rcshadman/OnSpeed-Gen2/Software/OnSpeedESP32S3/hardware/hardware.html

# OnSpeed on the ESP32-S3: hardware build

Board diagram, wiring schematic, pin map and parts list for replacing the Teensy 3.6 in an OnSpeed Gen2 box. Prices checked 2026-10-25, in USD.

Complete new box

$0

Every part bought new

Upgrading a Gen2 box

$0

Reusing sensors, IMU, enclosure, fittings, display

Pressure sensors

$0

Half the new-box cost; already in a Gen2 box

GPIO used

23 of 33

Plus USB for the console. No strapping or PSRAM pins

## Board diagram

The DevKitC-1 sits on a protoboard inside the existing Gen2 enclosure. Every connection to the aircraft is wired; there is no Wi-Fi in flight. Each colour is one kind of signal.

PowerI²C AnalogAudio (I²S) SerialCAN SD cardNumbers on the wires are ESP32-S3 GPIOs

## Wiring schematic

The four circuits that matter most for noise and reliability, drawn to the values in the parts list. Everything else is a direct wire from a module pin to the GPIO in the pin map.

## Connector pinout

The Gen2 DB-15 and harness are kept as they are, so an existing aircraft needs no rewiring. Pins come from the Gen2 Eagle netlist. MakerPlane CAN gets its own DB-9 because the DB-15 has no free pins.

DB-15 pin | Signal | To ESP32-S3 | Notes
1 | +12–14 V in | power chain → 5V | Through the 0.5 A PTC (Gen2 F1)
2 | EFIS RX (RS-232) | MAX3232 R1 → GPIO 15 | For example a Garmin G5 or Dynon serial out
3 | Panel switch | GPIO 5 | Data mark. Held at power-up, it enters ground maintenance mode
4 | GPS / VN-300 RX | MAX3232 R2 → GPIO 16
5 | AOA LED | GPIO 6 | 150R in series
6, 8 | Audio left / right | PCM5102A via the pad | Gen2 coupling caps C7 / C6. The PCM5102A output is already ground-centred
7 | Flap position | GPIO 1 | Divider + 100 nF
9 | Display TX | GPIO 10 | To the M5Stack, 3.3 V TTL
10 | Volume | GPIO 2 | Divider + 100 nF
11 | 3.3 V out | 3V3 via MF-R010 | Sensor/boom supply, Gen2 F2
12 | EFIS TX (RS-232) | GPIO 11 → MAX3232 T1
13 | Boom TTL RX | GPIO 7 | 3.3 V logic only; check each aircraft before connecting
14 | Ground | GND | Power return
15 | Audio ground | DAC AGND | Ground at the audio panel only
DB-9 (MakerPlane): pin 2 CAN-L, pin 7 CAN-H, pin 3 CAN GND, pin 1 +12–30 V (not used, box is powered from the DB-15), pin 5 power GND, pin 8 shield

## Pin map

GPIO | Signal | Peripheral | Why this pin

Left alone on purpose: 0, 3, 45, 46 (boot strapping), 35–37 (octal PSRAM), 19/20 (USB console), 43/44 (USB-UART bridge and ROM boot log), 38/48 (on-board LED). GPIO 11–20 are on ADC2, which Wi-Fi shares, so they carry only digital signals. The product PCB should use a WROOM-1-N8, never a "V" module.

## Flap sensor

All three options use the same input (DB-15 pin 7). The firmware learns each detent in a ground calibration, switches stage with hysteresis and a 0.2 s debounce, and holds the last good stage if the sensor fails open or short.

Option | How it works | Fit | Approx. cost
Linear Hall sensor (recommended for new installs) | A magnet on the flap torque tube, a Honeywell SS49E-type sensor on the structure. No contact, nothing to wear out. | Any stage count. Needs a small bracket. | $3–5
Position potentiometer (Ray Allen POS-12 or similar) | Many aircraft already have one for a flap indicator. Its wiper goes to pin 7. | Reuse what is installed. | already fitted
Detent switches + resistor ladder | One microswitch per detent, each switching in a different resistor, so one wire carries the stage. | Cheapest, but switches can bounce or corrode. | $5–10

## Parts list

Complete new box Upgrade a Gen2 box

Part | What it does | Qty | Unit | Total | Buy
Total

Prices are from the vendors' pages or findchips on 2026-10-25; small passives are approximate. Not included: the aircraft wiring and flap sensor, the optional ADS1115 ($14.95, only if the ESP32-S3 ADC proves too noisy) and, later, a custom PCB (about $5–30 for five boards plus a $4–5 WROOM-1 module).

## Noise and reliability

Each item below is a problem found in the datasheets, Espressif's docs or issue trackers, and what the build or firmware does about it.

Risk | Real numbers | What is done about it
Pressure sensor noise | MS4525DO: 1.05 Pa per count, about 1.5 counts RMS. One P45 count is 0.085° of AOA at 50 kt. | Median-of-15 then average-of-10 filter, as Gen2. Unit tests: steady AOA error 0.038°.
Bad or stale sensor reads | Status bits 10 = stale, 11 = fault. Gen2 ignored them. | Stale and faulty samples rejected. 25 bad reads in a row mutes the tones instead of giving a wrong tone; it recovers on its own.
I²C hang | ESP-IDF issue 12929: the bus can lock with a stuck device. | 2 ms timeouts and a bus reset after 10 failures. External 4.7k pull-ups (the internal 45k is too weak).
I²C speed | Gen2 ran at 3 MHz; the S3 tops out at 400 kHz. A 4-byte read takes 117.5 µs. | All reads for one 20 ms cycle take under 1 ms of bus time.
ADC noise | About 3 LSB RMS, 6 with Wi-Fi on, spikes near 30 LSB. Reference varies 1.0–1.2 V by chip. | ADC1 only, curve-fitted calibration, 32-sample average, 100 nF at the pin. Flap detents sit hundreds of counts apart.
Audio clock | The PCM5102A PLL cannot lock to 22.05 kHz. | I²S at 44.1 kHz.
Audio level | DAC 2.1 Vrms full scale; audio panel music inputs want under 0.2 Vrms at full volume. | −12 dB pad plus a firmware cap. Set it on the ground with the audio panel.
Pops at power-up | XSMT ramp 104 samples; the PLL needs 16 LRCK periods. | XSMT held low by a pull-down until I²S is clocking zeros.
Power transients | Bus can drop below 7 V when cranking; hot-plug spikes can pass 50 V. | D36V28F5 runs from 5.3 V, TVS + PTC, 47 µF bulk, brownout detector on.
Wi-Fi | Raises ADC noise and costs CPU. | Off in flight. Only on in ground maintenance mode (panel button held at power-up) or over USB.
Ground loops | Gen2 shares power and audio ground on the board. | Audio ground only at the audio panel; shielded twisted pair.
CPU headroom | CoreMark: S3 1329.92, Teensy 3.6 440.72. | About 3× the Teensy, with the second core free for the AHRS or display.

## Bench tests before flight

These can only be checked on real hardware. None of them should be skipped.

- Measure flap ADC noise in mV at each detent, with and without Wi-Fi. If detents are not cleanly separated, fit the ADS1115.
- Check the audio level and listen for hum on the actual audio panel, engine running.
- Power-cycle and crank the engine with the box on: no reset, no pop.
- Measure the boom and display logic levels on each aircraft before connecting (3.3 V only).
- Pull a sensor connector in flight-like conditions on the bench and confirm the tones mute and come back.
- Redo the AOA calibration flight: the 5 V-calibrated MS4525DO parts run at 3.3 V, as in Gen2. New builds can buy the 3.3 V version (DS3).
- Ask the FlyOnSpeed team (team@flyonspeed.org) about their ESP32 V4B board before laying out a PCB.
