rcshadman/OnSpeed-Gen2/Hardware/OnSpeedS3/fab/onspeed_bom_jlc.csv

Comment | Designator | Footprint | LCSC Part # | MPN | Qty
22uF 100V | C1 | CP_Elec_8x10 | C116424 | CS2A220M-CRF10 | 1
100nF | C2,C5 | C_0805_2012Metric | C28233 |  | 2
2.2uF | C3,C4 | C_1210_3225Metric | C86054 |  | 2
2.2nF | C6,C8,C47,C48 | C_0603_1608Metric | C1604 |  | 4
220pF | C7 | C_0805_2012Metric | C1805 |  | 1
22uF | C9,C10,C15,C20 | C_0805_2012Metric | C45783 |  | 4
100nF | C11,C12,C16,C18,C21,C22,C25,C26,C28,C29,C30,C31,C32,C33,C34,C36,C37,C40,C42,C43,C45,C49,C50,C51,C52,C53,C55,C57,C59 | C_0603_1608Metric | C14663 |  | 29
4.7uF | C13,C56 | C_0805_2012Metric | C1779 |  | 2
10uF | C14,C17,C19,C27,C41,C44,C46,C58 | C_0805_2012Metric | C15850 |  | 8
1uF | C23,C35 | C_0603_1608Metric | C15849 |  | 2
10nF | C24 | C_0603_1608Metric | C57112 |  | 1
2.2uF | C38,C39 | C_0603_1608Metric | C23630 |  | 2
4.7nF | C54 | C_0603_1608Metric | C53987 |  | 1
SS210 | D1 | D_SMA | C14996 | SS210 | 1
SMBJ58A | D2 | D_SMB | C10226 | SMBJ58A | 1
SS14 | D3,D19 | D_SMA | C2480 | SS14 | 2
Green | D4 | LED_0603_1608Metric | C72043 | 19-217/GHC-YR1S2/3T | 1
Blue | D5 | LED_0603_1608Metric | C72041 | 19-217/BHC-ZL1M2RY/3T | 1
15V bidir ESD | D6,D7,D8,D10,D11,D12,D13,D14 | D_SOD-323 | C2985482 | PESD15VL1BA | 8
24V bidir ESD | D9 | D_SOD-323 | C314263 | PESD24VL1BA | 1
BAT54S | D15,D16,D17,D18 | SOT-23 | C19726 | BAT54SLT1G | 4
PESD2CAN | D20 | SOT-23 | C2687131 | PESD2CAN | 1
0.75A 60V PTC | F1 | Fuse_2920_7451Metric | C210842 | MF-SM075/60-2 | 1
0.1A 15V PTC | F2 | Fuse_0603_1608Metric | C883088 | BSMD0603-010-15V | 1
220R@100MHz 2A | FB1 | L_0805_2012Metric | C85840 | BLM21PG221SN1D | 1
600R@100MHz 1.3A | FB2,FB3,FB4 | L_0603_1608Metric | C85833 | BLM18KG601SN1D | 3
USB-C 16P | J1 | USB_C_Receptacle_HRO_TYPE-C-31-M-12 | C165948 | TYPE-C-31-M-12 | 1
DA-15 female | J2 | DSUB-15_Female_Horizontal_P2.77x2.84mm_EdgePinOffset9.40mm_Holes33.32mm | C77835 | DS1037-15FNAKT74-0CC | 1
JST-GH 4P | J3 | JST_GH_SM04B-GHS-TB_1x04-1MP_P1.25mm_Horizontal | C189895 | SM04B-GHS-TB(LF)(SN) | 1
DE-9 male | J4 | DSUB-9_Male_Horizontal_P2.77x2.84mm_EdgePinOffset9.40mm_Holes24.99mm | C75750 | DS1037-09MNAKT74-0CC | 1
microSD push-pull | J5 | microSD_HC_Molex_104031-0811 | C585350 | 104031-0811 | 1
33uH 1.8A shielded | L1 | L_Changjiang_FNR6045S | C168083 | FNR6045S330MT | 1
330k | R1 | R_0603_1608Metric | C23137 |  | 1
100k | R2,R4,R6,R9 | R_0603_1608Metric | C25803 |  | 4
31.6k | R3,R5 | R_0603_1608Metric | C25967 |  | 2
150k | R7 | R_0603_1608Metric | C22807 |  | 1
8.2k | R8 | R_0603_1608Metric | C25981 |  | 1
5.1k | R10,R11 | R_0603_1608Metric | C23186 |  | 2
470 | R12,R15,R38,R40,R42,R44 | R_0603_1608Metric | C23179 |  | 6
10k | R13,R14,R37,R50,R52,R53,R54,R55,R56,R57 | R_0603_1608Metric | C25804 |  | 10
1k | R16,R25 | R_0603_1608Metric | C21190 |  | 2
20k | R17 | R_0603_1608Metric | C4184 |  | 1
150 | R18,R24 | R_0603_1608Metric | C22808 |  | 2
22k | R19,R21,R22 | R_0603_1608Metric | C31850 |  | 3
5.6k | R20,R23 | R_0603_1608Metric | C23189 |  | 2
0 | R26 | R_0603_1608Metric | C21189 |  | 1
200k | R27,R32 | R_0603_1608Metric | C25811 |  | 2
4.7k | R28,R29,R30,R31,R33,R34,R35,R36 | R_0603_1608Metric | C23162 |  | 8
560 | R39,R43 | R_0603_1608Metric | C23204 |  | 2
100 | R41,R45 | R_0603_1608Metric | C22775 |  | 2
120 | R46,R47,R48,R49 | R_0603_1608Metric | C22787 |  | 4
33 | R51 | R_0603_1608Metric | C23140 |  | 1
Tactile 4.2x3.2mm | SW1,SW2 | SW_SPST_PTS810 | C221895 | PTS810SJG250SMTRLFS | 2
LM5164DDAR | U1 | SOIC-8-1EP_3.9x4.9mm_P1.27mm_EP2.95x4.9mm_Mask2.71x3.4mm_ThermalVias | C477928 | LM5164DDAR | 1
USBLC6-2SC6 | U2 | SOT-23-6 | C7519 | USBLC6-2SC6 | 1
LDL1117S33R | U3 | SOT-223-3_TabPin2 | C435835 | LDL1117S33R | 1
ESP32-S3-WROOM-1-N8 | U4 | ESP32-S3-WROOM-1_BodyCourtyard | C2913198 | ESP32-S3-WROOM-1-N8 | 1
MS4525DO-DS5AI001DP | U5,U6 | MS4525DO_DIP8_500mil |  | MS4525DO-DS5AI001DP | 2
SSCSRNN1.6BA7A3 | U7 | Honeywell_SSC_SIP4_RN |  | SSCSRNN1.6BA7A3 | 1
PCA9306DCUR | U8,U9 | VSSOP-8_2.3x2mm_P0.5mm | C33196 | PCA9306DCUR | 2
ISM330DHCX | U10 | LGA-14_3x2.5mm_P0.5mm_LayoutBorder3x4y | C2655101 | ISM330DHCXTR | 1
PCM5102APWR | U11 | TSSOP-20_4.4x6.5mm_P0.65mm | C107671 | PCM5102APWR | 1
SP3232EEN-L/TR | U12 | SOIC-16_3.9x9.9mm_P1.27mm | C9378 | SP3232EEN-L/TR | 1
TJA1051T/3/1J | U13 | SOIC-8_3.9x4.9mm_P1.27mm | C38695 | TJA1051T/3/1J | 1
