rcshadman/OnSpeed-Gen2/Hardware/OnSpeedS3/enclosure/onspeed_enclosure_lid.stl

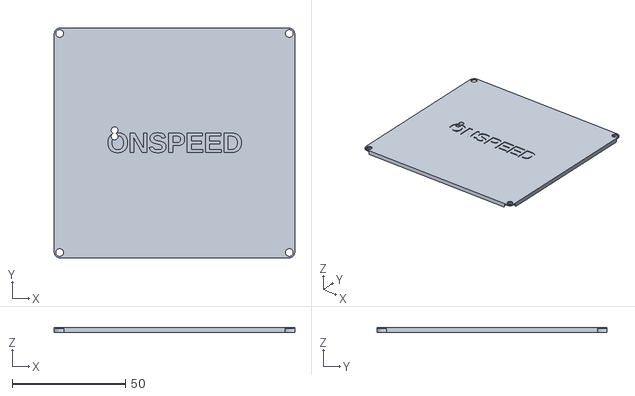
[picture p1: CAD file, 2026-10-25]
Hardware/OnSpeedS3/enclosure/onspeed_enclosure_lid.stl
106.2 x 101.5 x 2.40
