rcshadman/OnSpeed-Gen2/Hardware/OnSpeedS3/fab/onspeed_board.step

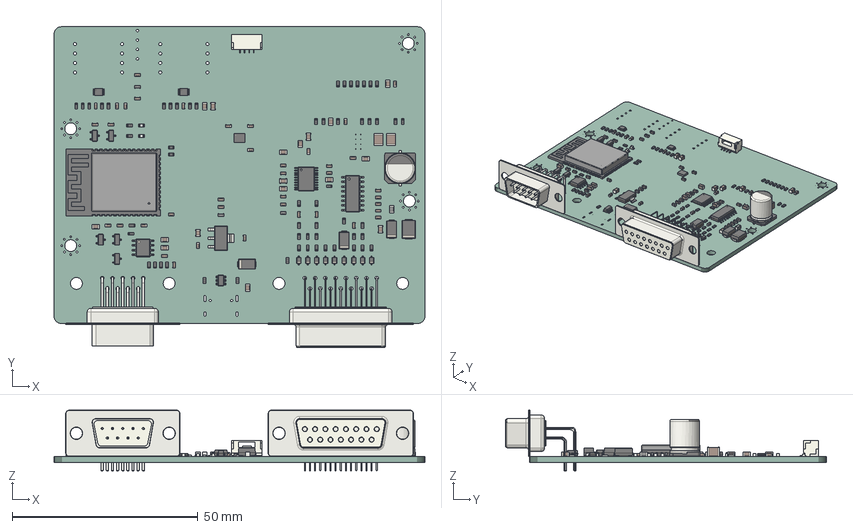
[picture p2: CAD file, 2026-10-25]
Hardware/OnSpeedS3/fab/onspeed_board.step
100.0 x 86.4 x 16.4 mm
R_0603_1608Metric x 57
C_0603_1608Metric x 39
D_SOD_323 x 9
CP_Elec_8x10
D_SMB
TSSOP_20_44x65mm_P065mm
LED_0603_1608Metric x 2
C_0805_2012Metric x 17
SOIC_8_39x49mm_P127mm
SOIC_16_39x99mm_P127mm
LGA_14_3x25mm_P05mm_LayoutBorder3x4y
JST_SM04B_GHS_TB
SOT_23 x 5
VSSOP_8_23x2mm_P05mm x 2
L_0603_1608Metric x 3
SOT_23_6
L_0805_2012Metric
D_SMA x 3
ESP32-S3-WROOM-1
Fuse_0603_1608Metric
DSUB_42_female
C_1210_3225Metric x 2
SOT_223
DSUB-9_Male_Horizontal_P2.77x2.84mm_EdgePinOffset9.40mm
onspeed_final PCB
