rcshadman/OnSpeed-Gen2/Hardware/OnSpeedS3/enclosure/onspeed_enclosure_base.stl

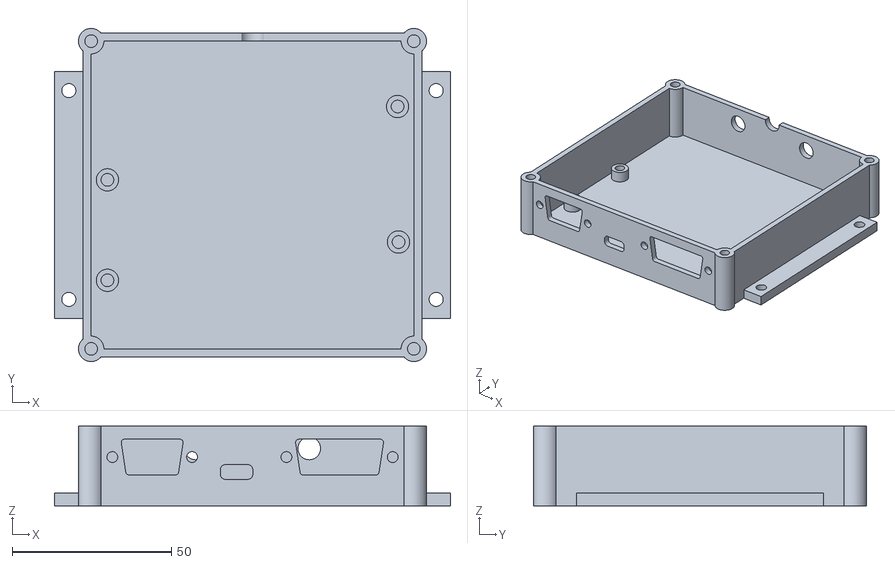
[picture p3: CAD file, 2026-10-25]
Hardware/OnSpeedS3/enclosure/onspeed_enclosure_base.stl
124.2 x 104.5 x 25.0
