rcshadman/OnSpeed-Gen2/Hardware/OnSpeedS3/fab/assembly_top.pdf

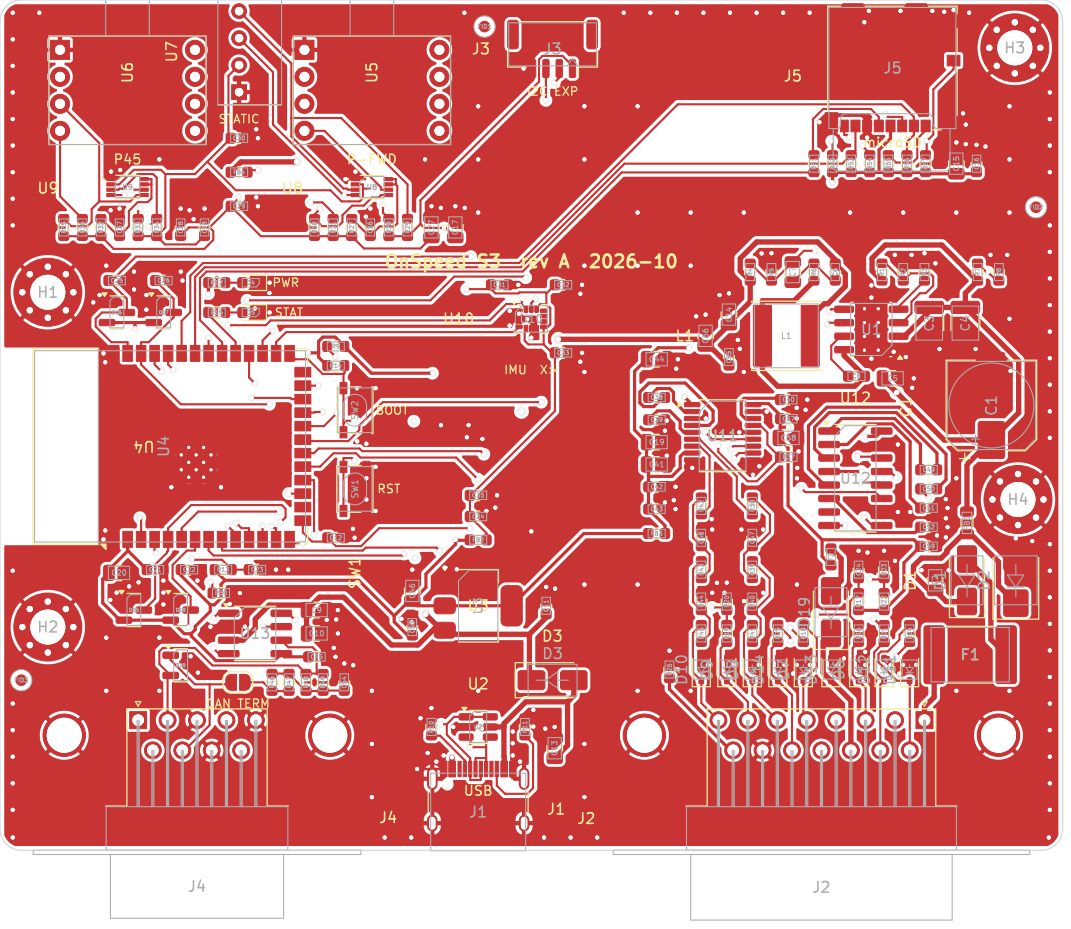
[picture p4: page 1]
