rcshadman/OnSpeed-Gen2/Hardware/OnSpeedS3/fab/copper_B_Cu.pdf

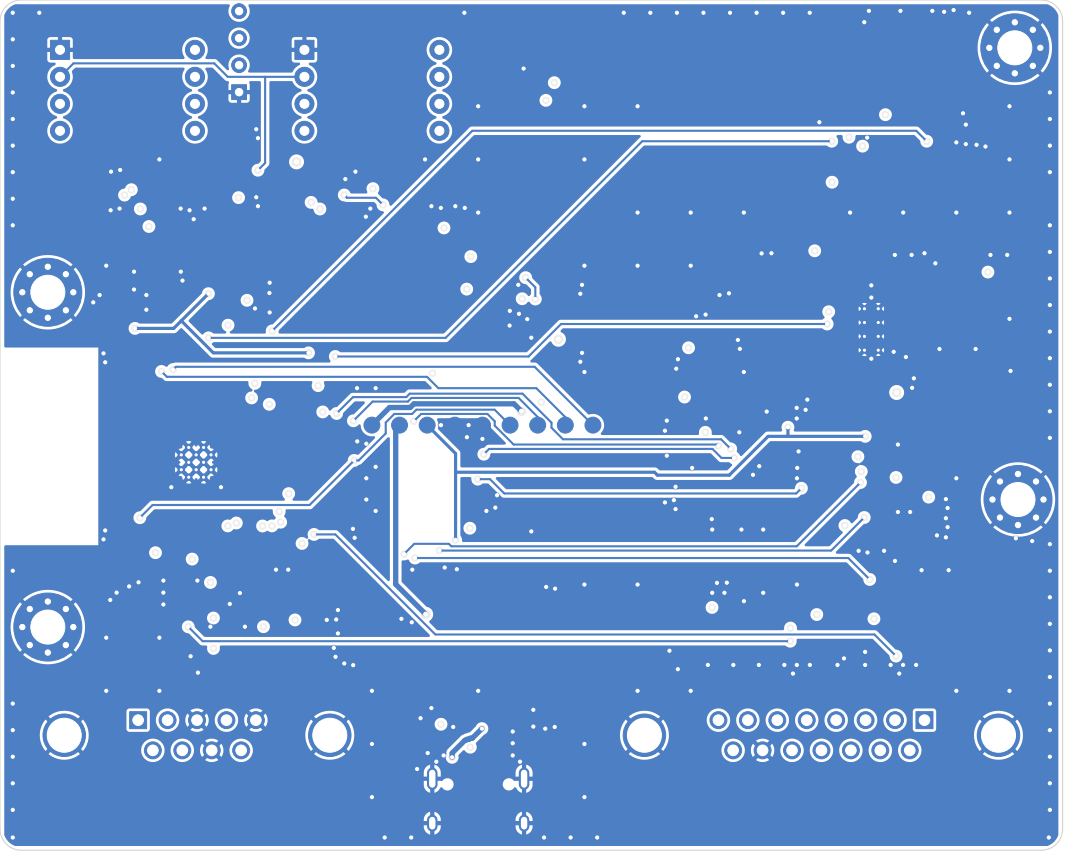
[picture p5: page 1]
