rcshadman/OnSpeed-Gen2/Hardware/OnSpeedS3/fab/copper_F_Cu.pdf

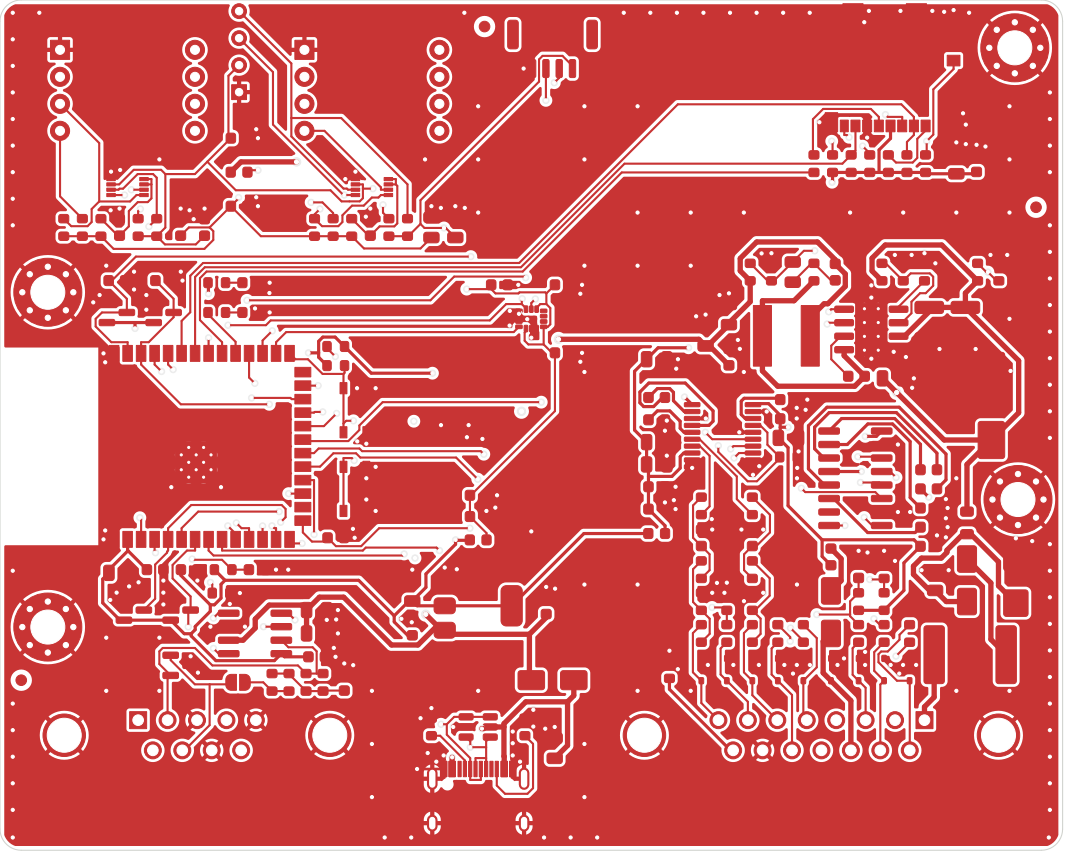
[picture p6: page 1]
