rcshadman/OnSpeed-Gen2/Hardware/OnSpeedS3/fab/copper_In1_Cu.pdf

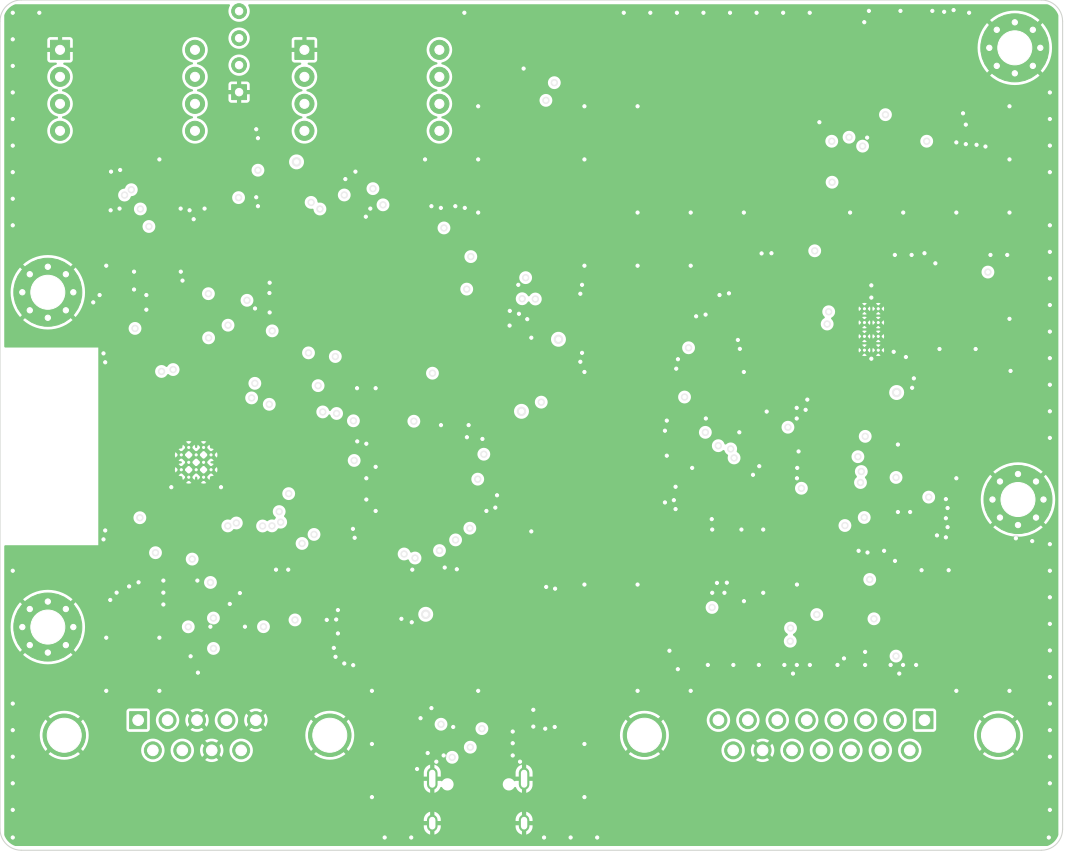
[picture p7: page 1]
