rcshadman/OnSpeed-Gen2/Hardware/OnSpeedS3/fab/copper_In2_Cu.pdf

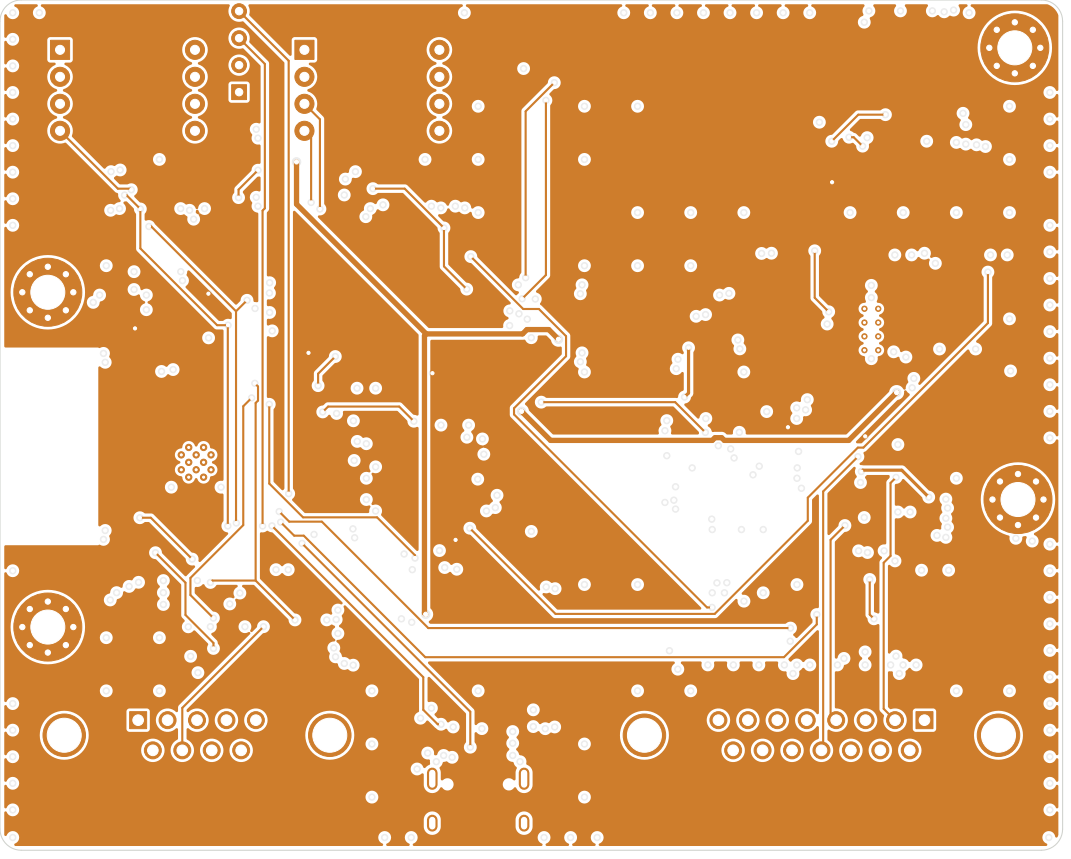
[picture p8: page 1]
