rcshadman/OnSpeed-Gen2/Hardware/OnSpeedS3/kicad/onspeed.kicad_pcb

## KiCad design Hardware/OnSpeedS3/kicad/onspeed.kicad_pcb (2026-10-25)

Schematic: onspeed.kicad_sch, OnSpeed ESP32-S3 main board

Parts:
C1: 22uF 100V; CP_Elec_8x10; Rating 100V, damps the input filter; above the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; MPN CS2A220M-CRF10; LCSC C116424
C2, C5: 100nF; C_0805_2012Metric; Rating 100V X7R; LCSC C28233
C3, C4: 2.2uF; C_1210_3225Metric; Rating 100V X7S; LCSC C86054
C6, C8, C47, C48: 2.2nF; C_0603_1608Metric; Rating 50V X7R; LCSC C1604
C7: 220pF; C_0805_2012Metric; Rating 50V C0G; LCSC C1805
C9, C10, C15, C20: 22uF; C_0805_2012Metric; Rating 25V X5R; LCSC C45783
C11, C12, C16, C18, C21, C22, C25, C26, C28, C29, C30, C31, C32, C33, C34, C36, C37, C40, C42, C43, C45, C49, C50, C51, C52, C53, C55, C57, C59: 100nF; C_0603_1608Metric; Rating 50V X7R; LCSC C14663
C13, C56: 4.7uF; C_0805_2012Metric; Rating 25V X5R; LCSC C1779
C14, C17, C19, C27, C41, C44, C46, C58: 10uF; C_0805_2012Metric; Rating 25V X5R; LCSC C15850
C23, C35: 1uF; C_0603_1608Metric; Rating 16V X7R; LCSC C15849
C24: 10nF; C_0603_1608Metric; Rating 50V X7R; LCSC C57112
C38, C39: 2.2uF; C_0603_1608Metric; Rating 16V X5R; LCSC C23630
C54: 4.7nF; C_0603_1608Metric; Rating 50V X7R; LCSC C53987
D1: SS210; D_SMA; MPN SS210; LCSC C14996
D2: SMBJ58A; D_SMB; MPN SMBJ58A; LCSC C10226
D3, D19: SS14; D_SMA; MPN SS14; LCSC C2480
D4: Green; LED_0603_1608Metric; MPN 19-217/GHC-YR1S2/3T; LCSC C72043
D5: Blue; LED_0603_1608Metric; MPN 19-217/BHC-ZL1M2RY/3T; LCSC C72041
D6, D7, D8, D10, D11, D12, D13, D14: 15V bidir ESD; D_SOD-323; MPN PESD15VL1BA; LCSC C2985482
D9: 24V bidir ESD; D_SOD-323; MPN PESD24VL1BA; LCSC C314263
D15, D16, D17, D18: BAT54S; SOT-23; MPN BAT54SLT1G; LCSC C19726
D20: PESD2CAN; SOT-23; MPN PESD2CAN; LCSC C2687131
F1: 0.75A 60V PTC; Fuse_2920_7451Metric; MPN MF-SM075/60-2; LCSC C210842
F2: 0.1A 15V PTC; Fuse_0603_1608Metric; MPN BSMD0603-010-15V; LCSC C883088
FB1: 220R@100MHz 2A; L_0805_2012Metric; MPN BLM21PG221SN1D; LCSC C85840
FB2, FB3, FB4: 600R@100MHz 1.3A; L_0603_1608Metric; MPN BLM18KG601SN1D; LCSC C85833
FID1, FID2, FID3: Fiducial; Fiducial_1mm_Mask2mm
H1, H2, H3, H4: M3; MountingHole_3.2mm_M3_Pad_Via
J1: USB-C 16P; USB_C_Receptacle_HRO_TYPE-C-31-M-12; MPN TYPE-C-31-M-12; LCSC C165948
J2: DA-15 female; DSUB-15_Female_Horizontal_P2.77x2.84mm_EdgePinOffset9.40mm_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; MPN DS1037-15FNAKT74-0CC; LCSC C77835
J3: JST-GH 4P; JST_GH_SM04B-GHS-TB_1x04-1MP_P1.25mm_Horizontal; MPN SM04B-GHS-TB(LF)(SN); LCSC C189895
J4: DE-9 male; DSUB-9_Male_Horizontal_P2.77x2.84mm_EdgePinOffset9.40mm_Hol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; MPN DS1037-09MNAKT74-0CC; LCSC C75750
J5: microSD push-pull; microSD_HC_Molex_104031-0811; MPN 104031-0811; LCSC C585350
JP1: CAN term; SolderJumper-2_P1.3mm_Open_RoundedPad1.0x1.5mm
L1: 33uH 1.8A shielded; L_Changjiang_FNR6045S; MPN FNR6045S330MT; LCSC C168083
R1: 330k; R_0603_1608Metric; LCSC C23137
R2, R4, R6, R9: 100k; R_0603_1608Metric; LCSC C25803
R3, R5: 31.6k; R_0603_1608Metric; LCSC C25967
R7: 150k; R_0603_1608Metric; LCSC C22807
R8: 8.2k; R_0603_1608Metric; LCSC C25981
R10, R11: 5.1k; R_0603_1608Metric; LCSC C23186
R12, R15, R38, R40, R42, R44: 470; R_0603_1608Metric; LCSC C23179
R13, R14, R37, R50, R52, R53, R54, R55, R56, R57: 10k; R_0603_1608Metric; LCSC C25804
R16, R25: 1k; R_0603_1608Metric; LCSC C21190
R17: 20k; R_0603_1608Metric; LCSC C4184
R18, R24: 150; R_0603_1608Metric; LCSC C22808
R19, R21, R22: 22k; R_0603_1608Metric; LCSC C31850
R20, R23: 5.6k; R_0603_1608Metric; LCSC C23189
R26: 0; R_0603_1608Metric; LCSC C21189
R27, R32: 200k; R_0603_1608Metric; LCSC C25811
R28, R29, R30, R31, R33, R34, R35, R36: 4.7k; R_0603_1608Metric; LCSC C23162
R39, R43: 560; R_0603_1608Metric; LCSC C23204
R41, R45: 100; R_0603_1608Metric; LCSC C22775
R46, R47, R48, R49: 120; R_0603_1608Metric; LCSC C22787
R51: 33; R_0603_1608Metric; LCSC C23140
SW1, SW2: Tactile 4.2x3.2mm; SW_SPST_PTS810; MPN PTS810SJG250SMTRLFS; LCSC C221895
TP1: VIN; TestPoint_Pad_D1.5mm
TP2: +5V; TestPoint_Pad_D1.5mm
TP3: +3V3; TestPoint_Pad_D1.5mm
TP4, TP5: GND; TestPoint_Pad_D1.5mm
TP6: EN; TestPoint_Pad_D1.5mm
TP7: BOOT; TestPoint_Pad_D1.5mm
TP8: U0TXD; TestPoint_Pad_D1.5mm
TP9: U0RXD; TestPoint_Pad_D1.5mm
U1: LM5164DDAR; SOIC-8-1EP_3.9x4.9mm_P1.27mm_EP2.95x4.9mm_Mask2.71x3.4mm_Th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; MPN LM5164DDAR; LCSC C477928
U2: USBLC6-2SC6; SOT-23-6; MPN USBLC6-2SC6; LCSC C7519
U3: LDL1117S33R; SOT-223-3_TabPin2; MPN LDL1117S33R; LCSC C435835
U4: ESP32-S3-WROOM-1-N8; ESP32-S3-WROOM-1_BodyCourtyard; MPN ESP32-S3-WROOM-1-N8; LCSC C2913198
U5, U6: MS4525DO-DS5AI001DP; MS4525DO_DIP8_500mil; MPN MS4525DO-DS5AI001DP
U7: SSCSRNN1.6BA7A3; Honeywell_SSC_SIP4_RN; MPN SSCSRNN1.6BA7A3
U8, U9: PCA9306DCUR; VSSOP-8_2.3x2mm_P0.5mm; MPN PCA9306DCUR; LCSC C33196
U10: ISM330DHCX; LGA-14_3x2.5mm_P0.5mm_LayoutBorder3x4y; MPN ISM330DHCXTR; LCSC C2655101
U11: PCM5102APWR; TSSOP-20_4.4x6.5mm_P0.65mm; MPN PCM5102APWR; LCSC C107671
U12: SP3232EEN-L/TR; SOIC-16_3.9x9.9mm_P1.27mm; MPN SP3232EEN-L/TR; LCSC C9378
U13: TJA1051T/3/1J; SOIC-8_3.9x4.9mm_P1.27mm; MPN TJA1051T/3/1J; LCSC C38695

Connections:
3V3_OUT_F: D19.2 (A), F2.2
+3V3: C15.1, C16.1, C20.1, C21.1, C22.1, C45.1, C46.1, C53.1, C57.1, C58.1, C59.1, D15.2 (K), D16.2 (K), D17.2 (K), D18.2 (K), F2.1, FB2.1, FB3.1, J5.4 (VDD), R9.2, R12.1, R13.1, R14.1, R17.1, R22.1, R52.1, R53.1, R54.1, R55.1, R56.1, R57.1, TP3.1, U3.2 (VO), U4.2 (3V3), U11.20 (DVDD), U12.16 (VCC), U13.5 (VIO)
+3V3_A: C19.1, C41.1, C42.1, C43.1, C44.1, FB3.2, U11.1 (CPVDD), U11.8 (AVDD)
+3V3_S: C17.1, C18.1, C30.1, C31.1, C32.1, C33.1, C34.1, C35.1, FB2.2, J3.1, R28.1, R29.1, R33.1, R34.1, U7.2 (VSUPPLY), U8.2 (VREF1), U9.2 (VREF1), U10.5 (VDDIO), U10.8 (VDD), U10.12 (CS)
+5V: C6.2, C9.1, C10.1, C11.1, C14.1, C55.1, C56.1, D3.1 (K), FB4.1, L1.2, R4.1, TP2.1, U3.3 (VI), U13.3 (VCC)
+5V_S: C27.1, C28.1, C29.1, FB4.2, R27.1, R30.1, R31.1, R32.1, R35.1, R36.1, U5.2 (VDD), U6.2 (VDD)
AUDIO_GND: J2.15, R26.1
AUDL_F: C47.1, R38.2, R39.1
AUDL_P: R39.2, R40.1, R41.1
AUDR_F: C48.1, R42.2, R43.1
AUDR_P: R43.2, R44.1, R45.1
BOOM_RX: D18.3 (COM), R25.2, U4.7 (IO7)
BOOT: R14.2, SW2.1, TP7.1, U4.27 (IO0)
BUCK_BST: C8.1, U1.7 (BST)
BUCK_EN: R1.2, R2.1, U1.3 (EN/UVLO)
BUCK_FB: C7.2, R4.2, R5.1, U1.5 (FB)
BUCK_RA: C6.1, C7.1, R6.2
BUCK_RON: R3.1, U1.4 (RON)
BUCK_SW: C8.2, L1.1, R6.1, U1.8 (SW)
CANH: D20.1 (K), J4.7, JP1.1 (A), U13.7 (CANH)
CANL: D20.2 (K), J4.2, R48.2, R49.2, U13.6 (CANL)
CAN_MID: C54.1, R46.2, R47.2, R48.1, R49.1
CAN_RX: U4.4 (IO4), U13.4 (RXD)
CAN_S: R50.1, U4.30 (IO37), U13.8 (S)
CAN_TH: JP1.2 (B), R46.1, R47.1
CAN_TX: U4.24 (IO47), U13.1 (TXD)
DAC_CAPM: C38.2, U11.4 (CAPM)
DAC_CAPP: C38.1, U11.2 (CAPP)
DAC_L: R38.1, U11.6 (OUTL)
DAC_LDOO: C40.1, U11.18 (LDOO)
DAC_R: R42.1, U11.7 (OUTR)
DAC_VNEG: C39.1, U11.5 (VNEG)
DAC_XSMT: R37.1, U4.23 (IO21), U11.17 (XSMT)
DISP_TX: R24.1, U4.18 (IO10)
EFIS_RX: U4.8 (IO15), U12.12 (R1OUT)
EFIS_TX: U4.19 (IO11), U12.11 (T1IN)
EN: C23.1, R13.2, SW1.1, TP6.1, U4.3 (EN)
FLAP_ADC: C25.1, D16.3 (COM), R19.2, R20.1, U4.39 (IO1)
GND: C1.2, C2.2, C3.2, C4.2, C5.2, C9.2, C10.2, C11.2, C12.2, C13.2, C14.2, C15.2, C16.2, C17.2, C18.2, C19.2, C20.2, C21.2, C22.2, C23.2, C24.2, C25.2, C26.2, C27.2, C28.2, C29.2, C30.2, C31.2, C32.2, C33.2, C34.2, C35.2, C36.2, C37.2, C39.2, C40.2, C41.2, C42.2, C43.2, C44.2, C45.2, C46.2, C47.2, C48.2, C51.2, C52.2, C53.2, C54.2, C55.2, C56.2, C57.2, C58.2, C59.2, D2.2 (A), D4.1 (K), D5.1 (K), D6.2 (A2), D7.2 (A2), D8.2 (A2), D9.2 (A2), D10.2 (A2), D11.2 (A2), D12.2 (A2), D13.2 (A2), D14.2 (A2), D15.1 (A), D16.1 (A), D17.1 (A), D18.1 (A), D20.3 (A), H1.1, H2.1, H3.1, H4.1, J1.A1 (GND), J1.A12 (GND), J1.B1 (GND), J1.B12 (GND), J1.S1 (SHIELD), J2.0 (PAD), J2.14, J3.4, J4.0 (PAD), J4.3, J4.5, J4.8, J5.6 (VSS), J5.10 (DET_A), J5.11 (SHIELD), R2.2, R3.2, R5.2, R8.2, R10.2, R11.2, R20.2, R23.2, R26.2, R37.2, R40.2, R44.2, R50.2, SW1.2, SW2.2, TP4.1, TP5.1, U1.1 (GND), U1.9 (EP), U2.2 (GND), U3.1 (GND), U4.1 (GND), U4.40 (GND), U4.41 (GND), U5.1 (GND), U6.1 (GND), U7.1 (GND), U8.1 (GND), U9.1 (GND), U10.1 (SDO/SA0), U10.2 (SDX), U10.3 (SCX), U10.6 (GND), U10.7 (GND), U11.3 (CPGND), U11.9 (AGND), U11.10 (DEMP), U11.11 (FLT), U11.12 (SCK), U11.16 (FMT), U11.19 (DGND), U12.10 (T2IN), U12.15 (GND), U13.2 (GND)
GPS_RX: U4.9 (IO16), U12.9 (R2OUT)
I2CA5_SCL: R31.2, U5.4 (SCL), U8.6 (SCL2)
I2CA5_SDA: R30.2, U5.3 (SDA), U8.5 (SDA2)
I2CA_SCL: R29.2, U4.17 (IO9), U7.4 (SCL), U8.3 (SCL1)
I2CA_SDA: R28.2, U4.12 (IO8), U7.3 (SDA), U8.4 (SDA1)
I2CA_VREF2: C36.1, R27.2, U8.7 (VREF2), U8.8 (EN)
I2CB5_SCL: R36.2, U6.4 (SCL), U9.6 (SCL2)
I2CB5_SDA: R35.2, U6.3 (SDA), U9.5 (SDA2)
I2CB_SCL: J3.2, R34.2, U4.11 (IO18), U9.3 (SCL1), U10.13 (SCL)
I2CB_SDA: J3.3, R33.2, U4.10 (IO17), U9.4 (SDA1), U10.14 (SDA)
I2CB_VREF2: C37.1, R32.2, U9.7 (VREF2), U9.8 (EN)
I2S_BCK: U4.20 (IO12), U11.13 (BCK)
I2S_DIN: U4.22 (IO14), U11.14 (DIN)
I2S_LRCK: U4.21 (IO13), U11.15 (LRCK)
IMU_INT1: U4.28 (IO35), U10.4 (INT1)
LED_OUT: R18.1, U4.6 (IO6)
LED_PWR: D4.2 (A), R12.2
LED_STAT: D5.2 (A), R15.2
PGOOD: R9.1, U1.6 (PGOOD), U4.25 (IO48)
RS232_EFIS_IN: J2.2, U12.13 (R1IN)
RS232_EFIS_OUT: J2.12, U12.14 (T1OUT)
RS232_GPS_IN: J2.4, U12.8 (R2IN)
RS_C1N: C49.2, U12.3 (C1-)
RS_C1P: C49.1, U12.1 (C1+)
RS_C2N: C50.2, U12.5 (C2-)
RS_C2P: C50.1, U12.4 (C2+)
RS_VN: C52.1, U12.6 (VS-)
RS_VP: C51.1, U12.2 (VS+)
SD_CLK: R51.1, U4.32 (IO39)
SD_CLK_C: J5.5 (CLK), R51.2
SD_CMD: J5.3 (CMD), R52.2, U4.33 (IO40)
SD_D0: J5.7 (DAT0), R53.2, U4.34 (IO41)
SD_D1: J5.8 (DAT1), R54.2
SD_D2: J5.1 (DAT2), R55.2
SD_D3: J5.2 (DAT3/CD), R56.2, U4.35 (IO42)
SD_DET: J5.9 (DET_B), R57.2, U4.29 (IO36)
STAT_LED: R15.1, U4.31 (IO38)
SW_IN: C24.1, D15.3 (COM), R16.2, R17.2, U4.5 (IO5)
U0RXD: TP9.1, U4.36 (RXD0)
U0TXD: TP8.1, U4.37 (TXD0)
USB_CC1: J1.A5 (CC1), R10.1
USB_CC2: J1.B5 (CC2), R11.1
USB_DM: J1.A7 (D-), J1.B7 (D-), U2.1 (I/O1), U2.6 (I/O1), U4.13 (IO19)
USB_DP: J1.A6 (D+), J1.B6 (D+), U2.3 (I/O2), U2.4 (I/O2), U4.14 (IO20)
VBUS: C13.1, D3.2 (A), J1.A4 (VBUS), J1.A9 (VBUS), J1.B4 (VBUS), J1.B9 (VBUS), U2.5 (VBUS)
VIN: C1.1, C3.1, C4.1, C5.1, FB1.2, R1.1, R7.1, TP1.1, U1.2 (VIN)
VIN_F: D1.2 (A), F1.2
VIN_P: C2.1, D1.1 (K), D2.1 (K), FB1.1
VIN_RAW: F1.1, J2.1
VIN_SENSE: C12.1, R7.2, R8.1, U4.15 (IO3)
VOL_ADC: C26.1, D17.3 (COM), R21.2, R22.2, R23.1, U4.38 (IO2)
X_3V3: D13.1 (A1), D19.1 (K), J2.11 (P111)
X_AUD_L: D8.1 (A1), J2.6, R41.2
X_AUD_R: D10.1 (A1), J2.8, R45.2
X_BOOM: D14.1 (A1), J2.13, R25.1
X_DISP: D11.1 (A1), J2.9, R24.2
X_FLAP: D9.1 (A1), J2.7, R19.1
X_LED: D7.1 (A1), J2.5, R18.2
X_SW: D6.1 (A1), J2.3, R16.1
X_VOL: D12.1 (A1), J2.10, R21.1

Notes on the sheet:
1 Aircraft power in, protection, 5 V buck (LM5164)
2 USB-C (power + flashing), 3.3 V LDO, filtered rails
3 ESP32-S3-WROOM-1-N8
4 DB-15 harness (Gen2 pinout) and line protection
5 Pressure sensors (Gen2 positions) and ISM330DHCX IMU
6 Audio: PCM5102A and 600 ohm intercom pad
7 RS-232 (EFIS in/out, GPS in): SP3232E
8 CAN-FiX (MakerPlane): TJA1051T/3, DE-9 male
9 microSD logging (1-bit SDMMC)
10 Mechanical: grounded M3 holes, fiducials
Order of protection: PTC (over-current) -> SS210 (reverse polarity) -> SMBJ58A (clamps 93.6 V, under the LM5164 100 V rating, so load dump and 28 V surges ride through) -> ferrite + 47 uF damped filter -> LM5164 (100 V rated).
USB VBUS feeds +5V through SS14, so the board runs and flashes from a laptop with no aircraft power. With both present the buck (5.0 V) carries the load.
Strapping: IO0 BOOT button + 10k up; IO3 carries the VIN monitor (strap only used if the JTAG eFuse is set); IO45/IO46 left open (internal pull-downs: 3.3 V flash, normal boot).
Every external line has a 15 V bidirectional ESD diode at the connector (flap may see 14 V; audio swings both ways). RS-232 lines rely on the SP3232E's own +/-15 kV protection.
Two MS4525DO share address 0x28, so each sits on its own bus (as the firmware expects).
Pad: 2.1 Vrms DAC -> about 0.39 Vrms into a 600 ohm panel input, source impedance about 420 ohm. DAC load stays above 1 kohm. PCM5102A outputs are ground-centred, so no DC blocking is needed.
Unused T2IN tied low so it cannot float.
DE-9: 2 CAN-L, 7 CAN-H, 3 CAN GND, 5 GND, 8 shield; pin 1 bus power not used.

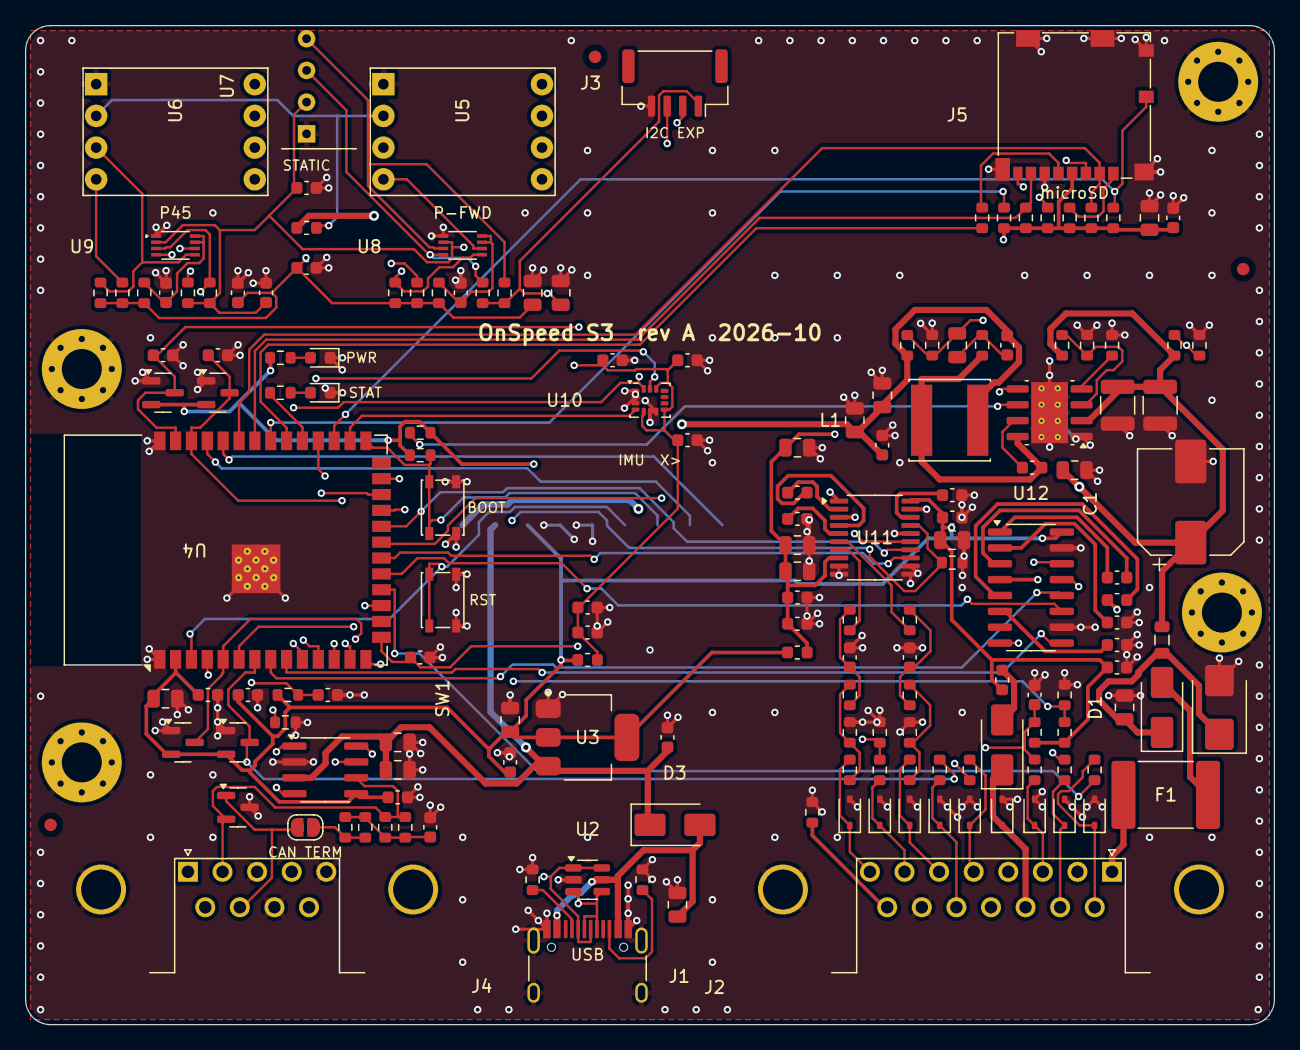
[picture p9: board onspeed.kicad_pcb from above]

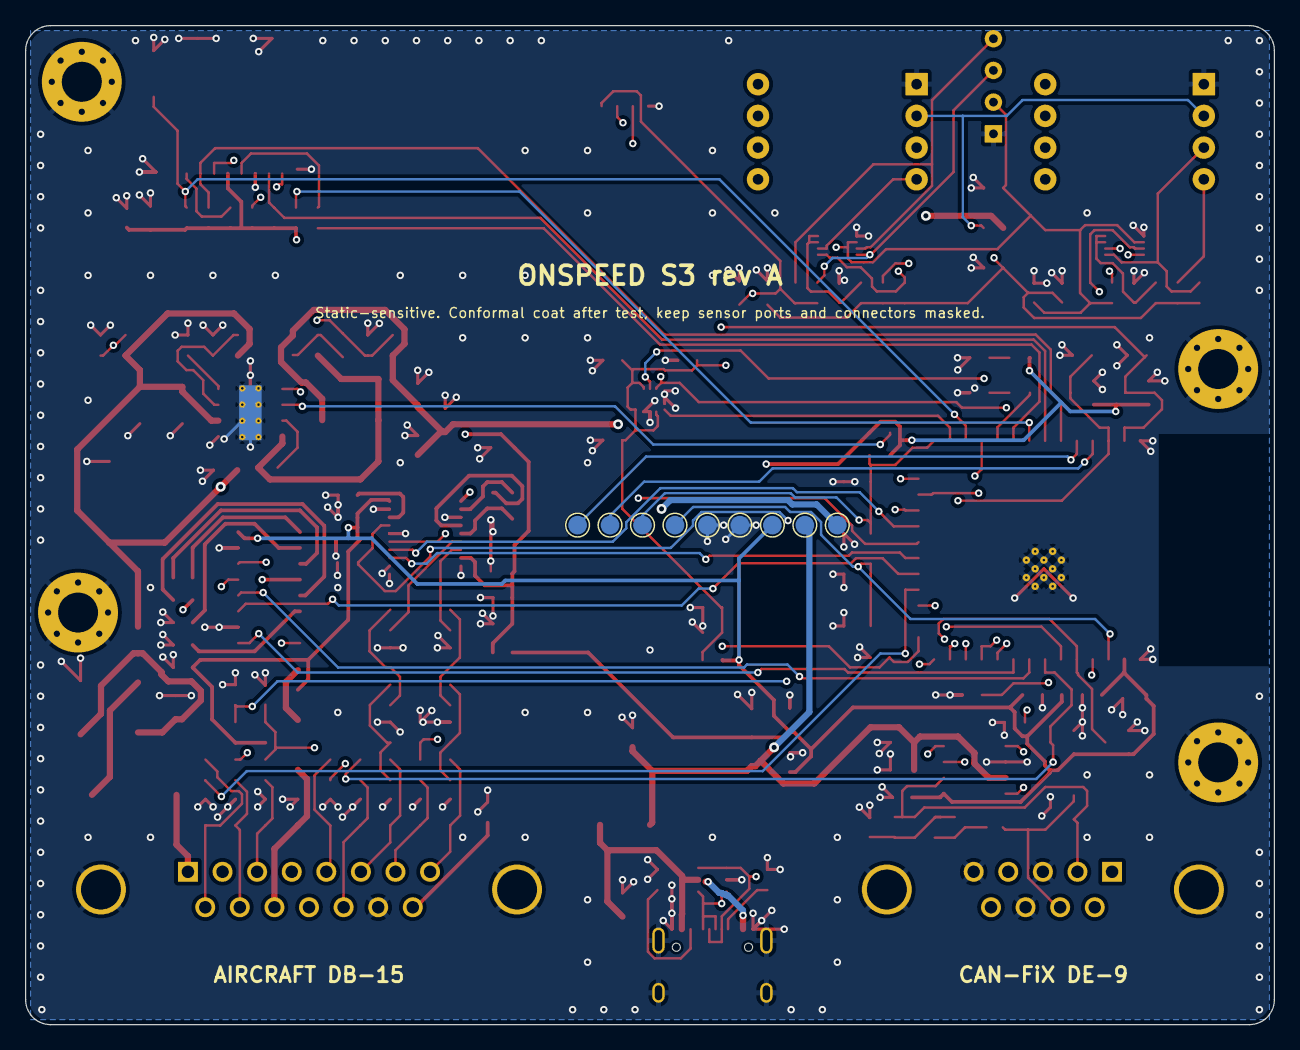
[picture p10: board onspeed.kicad_pcb from below]

Board: 4 copper layers, 100.0 x 80.0 mm, 180 parts (9 on the bottom side), 99 nets.
