rcshadman/OnSpeed-Gen2/(commit log)

2026-10-25 Add ESP32-S3 port of the OnSpeed core with QEMU virtual-board test
    Ports the Gen2 AOA, tone, display-sentence and G5 logic to plain C++
    (components/onspeed_core), runs it as FreeRTOS tasks on ESP32-S3, and adds
    the QEMU run checker, an independent Python Gen2 reference and a
    WebAssembly build of the core for the browser demo.
    Claude-Session: https://claude.ai/code/session_01CTCBGjc8HY34YnrwKs2YCc
2026-10-25 Add sensor fault handling, CAN-FiX link, host tests and the demo page
    - Core: per-sensor I2C/status-bit health; a 0.5 s run of failed or
    diagnostic reads mutes the tones instead of sounding wrong ones.
    Display sentence fields are clamped so out-of-range values cannot
    shift the layout under a valid checksum.
    - CAN-FiX encoder/decoder for the MakerPlane EFIS (AOA out, attitude
    and air data in), behind a small DisplaySink/EfisSource interface.
    - Host unit tests (ASan/UBSan) for parsing, filters, AOA, tone rules,
    display sentence, G5 parser, faults and the tone synth; CAN-FiX tests
    cross-checked against python-canfix.
    - Browser demo with the X-shaped indexer and a live manual mode.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
    [canfix.cpp, canfix.h, crosscheck.py, flight_model.cpp, main_twai_example.cpp, onspeed_core.cpp, onspeed_core.h, sim.h]
2026-10-25 ESP32-S3 port: AHRS, flap detector, DevKitC-1 pin map, hardware docs
    - Port the Gen2 AHRS (Madgwick + Kalman) to single-precision C++ and run it
    on the board from a simulated ISM330DHCX with datasheet noise and offsets.
    Seven bugs in the original are fixed behind fixKnownBugs (on in firmware).
    - Flap stage from a sensor: learn mode, hysteresis, 0.2 s debounce, and
    holding the last good stage on a sensor fault.
    - DevKitC-1 pin map (board_pins.h), 44.1 kHz I2S, mute sequencing,
    I2C timeouts and bus recovery, calibrated ADC in Gen2's 13-bit scale.
    - QEMU flight: 23 of 23 checks pass, including AHRS attitude and VSI.
    - hardware/: pin audit, real-data notes, parts list and wiring page.
    C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
    [ahrs.cpp, ahrs.h, bench.cpp, board_pins.h, check_run.py, gen2_reference.py, imu_sim.cpp, imu_sim.h]
2026-10-25 OnSpeed S3 custom board rev A: schematic, routed 4-layer PCB, JLC fab files, enclosure
    Board generated from Hardware/OnSpeedS3/generator/design.py: 189 parts, 4-layer
    100x80 mm, solid ground plane, every ground pin via-stitched. DRC clean, nothing
    unconnected. Input protection per the datasheet review: SMBJ58A TVS, 100 V bulk
    cap, 0.75 A PTC. Firmware pin map gains the custom-board pins and the new VIN
    divider (150k/8.2k).
    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
    [onspeed.kicad_pcb, onspeed.kicad_sch, onspeed_board.step, onspeed_bom_jlc.csv, onspeed_enclosure.scad, onspeed_enclosure_base.stl, onspeed_enclosure_lid.stl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]
